ChrisBall/Dub-Siren-Files/README.md

# Dub-Siren-Files
Code, manual and laser cutter files for a Dub Siren I made, with basic Tape Echo simulator

example video - https://www.youtube.com/watch?v=VJ9FtiL48HY

blog post - https://chrisballprojects.wordpress.com/2015/01/14/2014-2015-and-dub-sirens/
