ChrisBall/Dub-Siren-Files/Farnell BOM.md

Farnell Order Code | Name | Quantity | Details
--- | --- | --- | ---
1760787 | Audio Taper 10k Pot | 1 | Product Range:P160K Series; Track Resistance:10kohm; Track Taper:Logarithmic; No. of Turns:1; Shaft Diameter:6mm; Shaft Length - Metric:20mm; Resistance Tolerance:± 20%; Power Rating:100mW; Potentiom
2373467 | Bright Blue LED | 1 | KINGBRIGHT-L-964QBDL-D-LED, 3MM, EDGELESS, BLUE, 800MCD, 465NM
1782728 | Linear 10k Pot| 4 | Product Range:P160 Series; Track Resistance:10kohm; Track Taper:Linear; No. of Turns:1; Power Rating:200mW; Potentiometer Mounting:Through Hole; Shaft D 63M1595
9473386 | Toggle Switch | 2 | MULTICOMP-1MS3T1B5M1QE-SWITCH, SPDT, ON-OFF-ON, 5A, 28VDC
1440004 | Pot Knob Covers | 5 | MULTICOMP-CR-MS-3-KNOB, SOFT TOUCH, SPLINED SHAFT, BLU
1634623 | Push Buttons | 2 | Contact Configuration:SPST; Switch Operation:Off-(On); Contact Voltage AC Nom:125V; Contact Voltage DC Nom:-; Contact Current Max:3A; Switch Terminals:Solder; SVHC:No SVHC (17-Dec-2014); A
2250861 | Arduino Due | 1 | ARDUINO-A000062-AT91SAM3X8E, ARDUINO DUE, DEV BOARD
2473171 | Rubber Feet | 4 | Bumper / Feet Style:Round; Bumper / Feet Mounting:Press Fit; Bumper / Feet Material:Rubber; Bumper / Feet Color:Black; Height:3.175mm; SVHC:No SVHC (17-Dec-2014)
1097955 | Pin Headers | 1 | Product Range:BergStik 77311 Series; Pitch Spacing:2.54mm; No. of Rows:1; No. of Contacts:36; Gender:Header; Contact Termination Type:Through Hole; Contact Plating:Gold over Nickel;

####Just the order codes (for copying/pasting):
| Farnell Order Code |
| --- |
| 1760787 |
| 2373467 |
| 1782728 |
| 9473386 |
| 1440004 |
| 1634623 |
| 2250861 |
| 2473171 |
| 1097955 |

####Other parts required that are not included in the above list:

1 x Motherboard standoff screw 		(someone you know will have one of these)

1 x M3x20 screw				(check ebay. Can be purchased from farnell but in packs of 100)

Ribbon Cable 				(recycled from old IDE cables is fine)

1 x 10K ohm resistor			(most resistor kits will have these, this should be matched to the LED - I use 10k to severely limit brightness)

1 x 470 ohm resistor			(most resistor kits will have these)

1 x A4 laser grade 3mm plywood, cut  	(most laser cutting services should be able to take the .svg files given)

####Notes:

The A10K Pots given in the list above have not yet been tested in situ.
