ChrisBall/Dub-Siren-Files/(threads)

Thread 1 (2018-03-01):

Cant compile: size of array 'DELAYBUFFER' is too large

hunterofdoom, 2018-03-01:
Hi, i am using Arduino Due and im trying to upload your code to the arduino but i cant since the code has compilations errors, why is this happening? I didnt modify the code or something else..

hunterofdoom, 2018-03-02:
Nevermind, i didnt download basic libraries for Due and didnt select Arduino Due Device in Arduino IDE

Closed 2018-03-02.

Thread 2 (2020-08-20):

New users report horrible distortion, led flash rate too fast

ChrisBall, 2020-08-20:
"the audio output is heavily distorted and the frequency high pitched. Sounds nothing like in your youtube video. Also noticed that the rate LED flashes much faster than in your video even at the lowest setting"

ChrisBall, 2020-08-20:
Suspect linked to changes in the IDE/Due core. Will investigate this weekend.
Should also look into putting up some compiled binaries on here so this doesn't happen again :)

Closed 2022-03-08.

Thread 3 (2020-11-21):

Teensy 3.2 Port

ReeceKetley, 2020-11-21:
Hi, Greatwork with this i built and own a soundsystem which i want to use this with. However i'd like to use a Teensy 3.2 instead i've seen you'd already ported it to teensy so i assume its possible will you be releaseing the source code as im having issues porting myself. (specificly TC realted stuff)

ChrisBall, 2020-11-25:
Hi Reece - I've hesistated to put this code up because I still sell these. It's easily possible to adapt the existing code for Teensy 3.2.
The main change is to change the TC handler (the main audio interrupt) from the DUE hardware timer to fire instead on the teensy's timer - you can use the timerOne library instead. You will also need to reduce the audio buffer size to fit in the Teensy's smaller SRAM.

I also added warmer distortion, a LP filter in the feedback loop, and some MIDI functions in the teensy version, but of course these aren't necessary.

Let me know if you're having trouble with that and I can give pointers! I would consider uploading a basic version of the code for teensy that doesn't have the above features.

ReeceKetley, 2020-11-26:
Thank's for the reply i ended up writting my own from scratch and using an SRAM expansion to give me more memory for the delay. But i think ill move it to the 3.6 platform.

ChrisBall, 2020-11-27:
Nice!

Closed 2020-11-27.
