ChrisBall/Dub-Siren-Files/Dub_Synth_Due_Code/Dub_Synth_Due_Code.ino

//1024 values from A1 (55Hz) to A7 (3520Hz)
int NOTELOOKUP[]={
  65536, 65802, 66071, 66340, 66610, 66881, 67154, 67427, 67702, 67978, 68255, 68533, 68812, 69092, 69374, 69656, 69940, 70225, 70511, 70798, 71087, 71376, 71667, 71959, 72252, 72546, 72842, 73139, 73437, 73736, 74036, 74338, 
  74641, 74945, 75250, 75557, 75864, 76173, 76484, 76795, 77108, 77422, 77738, 78054, 78372, 78692, 79012, 79334, 79657, 79982, 80307, 80635, 80963, 81293, 81624, 81957, 82290, 82626, 82962, 83300, 83640, 83980, 84322, 84666, 
  85011, 85357, 85705, 86054, 86404, 86756, 87110, 87465, 87821, 88179, 88538, 88899, 89261, 89624, 89990, 90356, 90724, 91094, 91465, 91837, 92212, 92587, 92964, 93343, 93723, 94105, 94489, 94873, 95260, 95648, 96038, 96429, 
  96822, 97216, 97612, 98010, 98409, 98810, 99212, 99617, 100022, 100430, 100839, 101250, 101662, 102076, 102492, 102910, 103329, 103750, 104172, 104597, 105023, 105451, 105880, 106312, 106745, 107180, 107616, 108055, 108495, 108937, 109381, 109826, 
  110274, 110723, 111174, 111627, 112081, 112538, 112996, 113457, 113919, 114383, 114849, 115317, 115787, 116258, 116732, 117207, 117685, 118164, 118646, 119129, 119614, 120101, 120591, 121082, 121575, 122070, 122568, 123067, 123568, 124072, 124577, 125085, 
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
  2711, 2706, 2701, 2696, 2691, 2686, 2681, 2676, 2671, 2665, 2660, 2655, 2650, 2645, 2640, 2635, 2630, 2625, 2620, 2614, 2609, 2604, 2599, 2594, 2589, 2584, 2579, 2574, 2568, 2563, 2558, 2553, 
  2548, 2543, 2538, 2533, 2528, 2522, 2517, 2512, 2507, 2502, 2497, 2492, 2487, 2482, 2477, 2471, 2466, 2461, 2456, 2451, 2446, 2441, 2436, 2431, 2425, 2420, 2415, 2410, 2405, 2400, 2395, 2390, 
  2385, 2379, 2374, 2369, 2364, 2359, 2354, 2349, 2344, 2339, 2334, 2328, 2323, 2318, 2313, 2308, 2303, 2298, 2293, 2288, 2282, 2277, 2272, 2267, 2262, 2257, 2252, 2247, 2242, 2236, 2231, 2226, 
  2221, 2216, 2211, 2206, 2201, 2196, 2191, 2185, 2180, 2175, 2170, 2165, 2160, 2155, 2150, 2145, 2139, 2134, 2129, 2124, 2119, 2114, 2109, 2104, 2099, 2093, 2088, 2083, 2078, 2073, 2068, 2063, 
  2058, 2053
};

#define SAMPLE_RATE 44100.0
#define TICKS_PER_CYCLE (4294967296.0/SAMPLE_RATE)

#define BIAS 2048

#define LEDPIN 53

int POT0=0,POT1=0,POT2=0,POT3=0;
int64_t iter=0; 
int64_t modIter=0; 
int out_DAC0;

const byte BUTTONS[]={8,9,10,11,12,13};             //main trigger, scale trigger; mod sine on, mod saw on (else square); main sine on, main saw on (else square)
byte BUTTONSTATES[]={0,0,0,0,0,0};

#define FADEMAX 512    //512 samples attack and release (sustain always 1)
unsigned int FADE=0;    //used in ASR

#define MAXDELAYBUFFERSIZE 40000  //nearly 1 second of delay
short DELAYBUFFER[MAXDELAYBUFFERSIZE];
unsigned int delayWriteIndex=0; 
unsigned int pDelayWriteIndex=0;

//---------------------------------------------------------------------------------------------------------------------------------------------------------------

void setup()
{
  //Serial.begin(115200);   
  /* turn on the timer clock in the power management controller */
  pmc_set_writeprotect(false);
  pmc_enable_periph_clk(ID_TC4);
  /* we want wavesel 01 with RC */
  TC_Configure(/* clock */TC1,/* channel */1, TC_CMR_WAVE | TC_CMR_WAVSEL_UP_RC | TC_CMR_TCCLKS_TIMER_CLOCK2);
  TC_SetRC(TC1, 1, 238); // sets <> 44.1 Khz interrupt rate
  TC_Start(TC1, 1);
  TC1->TC_CHANNEL[1].TC_IER=TC_IER_CPCS;
  TC1->TC_CHANNEL[1].TC_IDR=~TC_IER_CPCS;
  NVIC_EnableIRQ(TC4_IRQn);
  
  analogWrite(DAC0,0);
 
  pinMode(LEDPIN,OUTPUT);
  
  for(int i=0;i<6;i++){
    pinMode(BUTTONS[i],INPUT_PULLUP);  //begin button pins
  }
  
  for(int i=0;i<MAXDELAYBUFFERSIZE;i++){
    DELAYBUFFER[i]=BIAS; //initialise delay buffer to 'zero'
  }
}

//---------------------------------------------------------------------------------------------------------------------------------------------------------------

void loop()
{
  POT0 = analogRead(A0);  //frequency
  POT1 = analogRead(A1);  //mod frequency
  POT2 = analogRead(A2);  //delay  
  POT3 = analogRead(A3);  //feedback
  
//  Serial.print(POT0); Serial.print("\t");
//  Serial.print(POT1); Serial.print("\t");
//  Serial.print(POT2); Serial.print("\t");
//  Serial.print(POT3); Serial.print("\t");
//  Serial.print(BUTTONSTATES[0]); Serial.println("\t");
  
  if((delayWriteIndex<(20500<<16))||(POT2==0)){
    digitalWrite(LEDPIN,HIGH);
  }else{
    digitalWrite(LEDPIN,LOW);
  }
  //get button states
  buttonUpdate();
}

//---------------------------------------------------------------------------------------------------------------------------------------------------------------

void TC4_Handler()
{
  // We need to get the status to clear it and allow the interrupt to fire again
  TC_GetStatus(TC1, 1);
  
  //reset mod index upon 'scale' push
  if(BUTTONSTATES[1]==3){
    modIter=0;
  }
  
  if((BUTTONSTATES[0]==2)||(BUTTONSTATES[1]==2)||(FADE>0)){
    //MOD OSC--------------------------------------------------------------------------------
    int modval=0;
    modIter+=(NOTELOOKUP[POT1]-65536)>>4;                    //mod rate: tweak as necessary
    modIter%=SINLOOKUPSIZE<<16;  
    if(BUTTONSTATES[2]==2){                                          //MOD SINE
      modval=getBufInterp(SINLOOKUP,SINLOOKUPSIZE,modIter);                         //interpolation may not be necessary?
    }else if(BUTTONSTATES[3]==2){                                    //MOD SAW
      modval=getBufInterp(SAWLOOKUP,SINLOOKUPSIZE,modIter);  
    }else{                                                           //MOD SQUARE
      modval=getBufInterp(SINLOOKUP,SINLOOKUPSIZE,modIter); 
      if(modval>2047){
        modval=4095;
      }else if(modval<2047){
        modval=0;
      }else{
        modval=2047;
      }
    }
    modval=(modval<<5)-65536;   //mod amount
    
    //MAIN OSC--------------------------------------------------------------------------------
    
    if(BUTTONSTATES[1]==2){      //scale function
      iter+=NOTELOOKUPSCALE[POT0];
    }else{
      iter+=NOTELOOKUP[POT0];
    }
    
    iter+=modval; 
    iter%=SINLOOKUPSIZE<<16; 
    
    if(BUTTONSTATES[4]==2){    
      out_DAC0=getBufInterp(SINLOOKUP,SINLOOKUPSIZE,iter);  
    }else if(BUTTONSTATES[5]==2){
      out_DAC0=getBufInterp(SAWLOOKUP,SINLOOKUPSIZE,iter);  
    }else{  
      out_DAC0=getBufInterp(SINLOOKUP,SINLOOKUPSIZE,iter);  
      if(out_DAC0>2047){
        out_DAC0=4095;
      }else{
        out_DAC0=0;
      }
    }

    //ASR--------------------------------------------------------------------------------------
    if((FADE<FADEMAX)&&((BUTTONSTATES[0]==2)||(BUTTONSTATES[1]==2))){                //remove &&((BUTTONSTATES[0]==2)||(BUTTONSTATES[1]==2)) for weird noises
      FADE++;
    }else{
      FADE--;
    }
    out_DAC0=volumeMult4096(out_DAC0,FADE<<7);                                 //output volume set at 100% (FADE<<6 instead of FADE<<7 would be 50%)
    
  }else{
    out_DAC0=BIAS;
  }
  
  //delay,feedback,filtering-----------
  pDelayWriteIndex=delayWriteIndex;                                                             //store the previous index (for filling in the gaps later)
  delayWriteIndex+=POT2<<9;                                                                     //increase the index by the specified amount, to the 'oldest' sample
  
  //crappy filtering - take a equal mix of current and last sample (2 tap rectangular moving average filter - good for high frequency clicks but not very noticeable otherwise)
  int oldsample=volumeMix4096(getBufInterp(DELAYBUFFER,MAXDELAYBUFFERSIZE,delayWriteIndex),getBufInterp(DELAYBUFFER,MAXDELAYBUFFERSIZE,pDelayWriteIndex),32768); //read oldest sample
  
  oldsample=volumeMult4096(oldsample,((POT3*3)>>1)<<6);  //multiply feedback amount (to 150%)
  
  out_DAC0=volumeAdd4096(oldsample,out_DAC0);       //add the oldest sample to the output
  
  for(unsigned int i=(pDelayWriteIndex>>16);i<(delayWriteIndex>>16);i++){
    int index=i%MAXDELAYBUFFERSIZE;
    DELAYBUFFER[index]=out_DAC0; //write all samples the same! this loop could get messy in short delay times (bigger jumps, longer runs to fill);
  }
    
  delayWriteIndex%=MAXDELAYBUFFERSIZE<<16;                                                      //limit the index so it's always within the array
  
  dacc_write_conversion_data(DACC_INTERFACE, out_DAC0);
}

//---------------------------------------------------------------------------------------------------------------------------------------------------------------

int getBufInterp(short int* ARRAYINPUT, int BUFFSIZE, unsigned int INDEX){
  //INDEX should be float bufferPosition * 2^16
  //linear interpolation - allows you to ask for an array entry between indexes e.g. getValInterp(listOfValues, 1024, 34.7*(2^16)); will return a proportional mix of the values at indexes 34 and 35
  //will loop back at the end of the array, e.g. it's possible to request indexes longer than the input
  int LOWER  = INDEX>>16;
  if((INDEX%65536)==0){
    return (ARRAYINPUT[LOWER%BUFFSIZE]);
  }else{
    return linInterp(ARRAYINPUT[LOWER%BUFFSIZE], ARRAYINPUT[(LOWER+1)%BUFFSIZE], INDEX%65536);
  }
}

//---------------------------------------------------------------------------------------------------------------------------------------------------------------

int linInterp(int IN1, int IN2, int WEIGHT){
  return (IN1*(65536-WEIGHT) + IN2*WEIGHT)>>16;
}

//---------------------------------------------------------------------------------------------------------------------------------------------------------------

int volumeMult4096(int INPUTSAMPLE,int VOLFACTOR){
  //simple linear volume change (clips over 1) 
  //INPUTSAMPLE is between 0 and 4095
  //VOLFACTOR is equal to 2^16F, e.g. a doubling of volume would be 2^16*2 = 131072, assumes bias of 2048
  return constrain((((INPUTSAMPLE-BIAS)*VOLFACTOR)>>16)+BIAS,0,4095);
}
//---------------------------------------------------------------------------------------------------------------------------------------------------------------

int volumeMix4096(int INPUTSAMPLE1,int INPUTSAMPLE2,int MIX){
  //simple volume mixer for two samples, contrains to 4095, variable mix of two samples, MIX should be expressed x*(2^16) where x is between 0 and 1.
  return constrain((INPUTSAMPLE1*(65536-MIX)+INPUTSAMPLE2*MIX)>>16,0,4095);
}
//---------------------------------------------------------------------------------------------------------------------------------------------------------------

int volumeAdd4096(int INPUTSAMPLE1,int INPUTSAMPLE2){   //beware unsigned
  //simple volume adder for two samples, contrains to 4095, assumes bias of 2048
  return constrain(INPUTSAMPLE1+INPUTSAMPLE2-BIAS,0,4095);
}


//---------------------------------------------------------------------------------------------------------------------------------------------------------------

void buttonUpdate(){
  for(int i=0;i<6;i++){
    boolean buttonState=digitalRead(BUTTONS[i]);
    if(BUTTONSTATES[i]==3){
      BUTTONSTATES[i]=2;
    }
    if((buttonState==LOW)&&(BUTTONSTATES[i]==0)){
      BUTTONSTATES[i]=3;
    }
    if(BUTTONSTATES[i]==1){
      BUTTONSTATES[i]=0;
    }
    if((buttonState==HIGH)&&(BUTTONSTATES[i]==2)){
      BUTTONSTATES[i]=1;
    }
  }
}
