ChrisBall/Dub-Siren-Files/(commit log)

2015-01-14 Dub Siren Files
    Added .ino code (Due) and laser cutting files
2015-04-25 pre-production run changes
    added placeholder manual file, updated laser cutter files
2015-04-25 Changes to laser cutter file
    added QR-code link to manual on Github
2015-04-25 Updated Laser Cutter files
    new QR code added
2015-04-25 Minor Manual update, laser files updated
2015-04-25 Laser Cutter Files update
    fancier QR code
2015-04-26 laser cut order changes
2015-05-04 Updated code & laser files
    changed way sound is generated (for new 'scale' button) & added USB port
    hole on case
2015-05-05 added signal chain diagram
2015-05-05 tweaked mod rate, scale behaviour
    -mod rate now log scale, higher max mod rate
    -fixed awesome fade bug (sounded awesome)
    [Dub_Synth_Due_Code.ino]
2015-05-07 minor fixes & changes
    [Dub_Synth_Due_Code.ino]
2015-05-13 Added Schematic, Minor code changes
2015-05-13 Draft Farnell BOM added
    BOM
2015-05-13 format changes BOM
2015-05-13 added schematic
2015-05-21 Added high pass filter to schematic, changed code
    -added high pass filter to schematic
    -more sensible pin assignments
2016-02-07 updated buffer size
    The code is not compiling in the current arduino IDE (out of RAM error), perhaps the Due bootloader takes up more space now. Reduced MAXDELAYBUFFERSIZE from 41000 to 40000.
    [Dub_Synth_Due_Code.ino]
2020-08-23 added newly compiled binary
    "Dub_Synth_Due_Code.ino.bin" compiled on arduino 1.8.12
